SilkT/canfd-to-usb/hw/canfd-usb-nucleo-expb/canfd-usb-nucleo-expb.kicad_pcb

## KiCad design hw/canfd-usb-nucleo-expb/canfd-usb-nucleo-expb.kicad_pcb (2020-03-15)

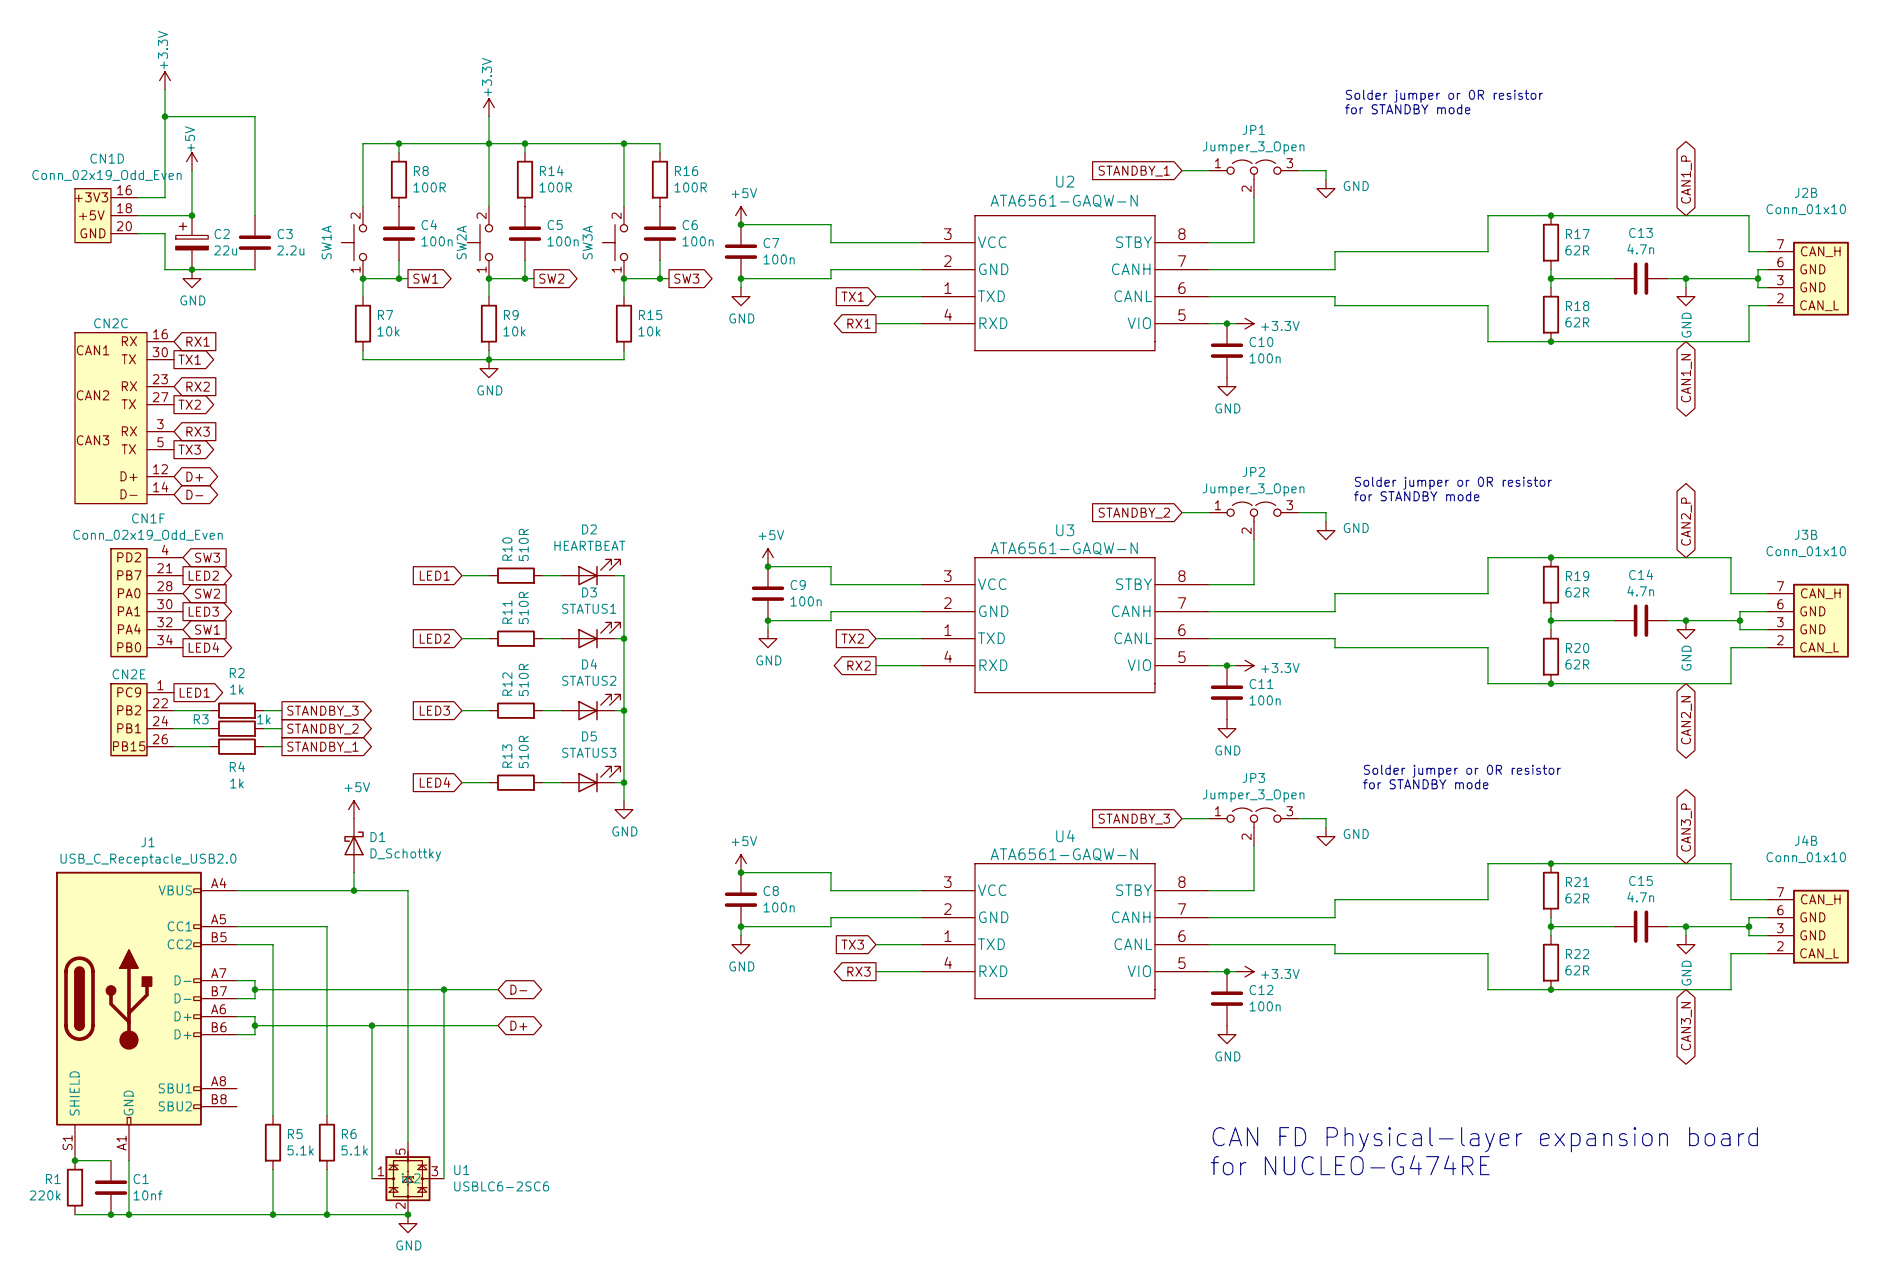
[picture p1: schematic canfd-usb-nucleo-expb.sch]

Parts:
C1: 10nf; C_0805_HandSoldering
C2: 22u; C_0805_HandSoldering
C3: 2.2u; C_0805_HandSoldering
C4, C5, C6, C7, C8, C9, C10, C11, C12: 100n; C_0805_HandSoldering
C13, C14, C15: 4.7n; C_0805_HandSoldering
CN1: Conn_02x19_Odd_Even; Pin_Header_Straight_2x19_Pitch2.54mm
CN2: CONN; Pin_Header_Straight_2x19_Pitch2.54mm
D1: D_Schottky; D_SOD-123
D2: HEARTBEAT; LED_D3.0mm
D3: STATUS1; LED_D3.0mm
D4: STATUS2; LED_D3.0mm
D5: STATUS3; LED_D3.0mm
J1: USB_C_Receptacle_USB2.0; L-KLS1-TIPEC-B
J2, J3, J4: Conn_01x10; IDC-Header_2x05_P2.54mm_Vertical
JP1, JP2, JP3: Jumper_3_Open; SolderJumper-3_P1.3mm_Open_RoundedPad1.0x1.5mm
R1: 220k; R_0805_HandSoldering
R2, R3, R4: 1k; R_0805_HandSoldering
R5, R6: 5.1k; R_0805_HandSoldering
R7, R9, R15: 10k; R_0805_HandSoldering
R8, R14, R16: 100R; R_0805_HandSoldering
R10, R11, R12, R13: 510R; R_0805_HandSoldering
R17, R18, R19, R20, R21, R22: 62R; R_0805_HandSoldering
SW1, SW2, SW3: SW_Push_Dual_x2; SW_PUSH_6mm
U1: USBLC6-2SC6; SOT-23-6_Handsoldering
U2, U3, U4: ATA6561-GAQW-N; SOIC-8_3.9x4.9mm_Pitch1.27mm

Connections:
+3V3: C3.1, C10.1, C11.1, C12.1, CN1.16, R8.1, R14.1, R16.1, SW1.2 (D), SW2.2 (D), SW3.2 (D), U2.5 (VIO), U3.5 (VIO), U4.5 (VIO)
+5V: C2.1, C7.1, C8.1, C9.1, CN1.18, D1.1 (K), U2.3 (VCC), U3.3 (VCC), U4.3 (VCC)
CAN1_N: J2.2, R18.2, U2.6 (CANL)
CAN1_P: J2.7, R17.1, U2.7 (CANH)
CAN2_N: J3.2, R20.2, U3.6 (CANL)
CAN2_P: J3.7, R19.1, U3.7 (CANH)
CAN3_N: J4.2, R22.2, U4.6 (CANL)
CAN3_P: J4.7, R21.1, U4.7 (CANH)
D+: CN2.12, J1.A6 (D+), J1.B6 (D+), U1.1, U1.6 (io1)
D-: CN2.14, J1.A7 (D-), J1.B7 (D-), U1.3 (io2), U1.4 (io2)
GND: C1.2, C2.2, C3.2, C7.2, C8.2, C9.2, C10.2, C11.2, C12.2, C13.2, C14.2, C15.2, CN1.20, D2.1 (K), D3.1 (K), D4.1 (K), D5.1 (K), J1.A1 (GND), J1.A12 (GND), J1.B1 (GND), J1.B12 (GND), J2.3, J2.6, J3.3, J3.6, J4.3, J4.6, JP1.3 (B), JP2.3 (B), JP3.3 (B), R1.1, R5.2, R6.2, R7.2, R9.2, R15.2, U1.2, U2.2 (GND), U3.2 (GND), U4.2 (GND)
LED1: CN2.1, R10.1
LED2: CN1.21, R11.1
LED3: CN1.30, R12.1
LED4: CN1.34, R13.1
unnamed: C1.1, J1.S1 (SHIELD), R1.2
unnamed: C4.1, R8.2
unnamed: C5.1, R14.2
unnamed: C6.1, R16.2
unnamed: C13.1, R17.2, R18.1
unnamed: C14.1, R19.2, R20.1
unnamed: C15.1, R21.2, R22.1
unnamed: CN2.22, R2.1
unnamed: CN2.24, R3.1
unnamed: CN2.26, R4.1
unnamed: D1.2 (A), J1.A4 (VBUS), J1.A9 (VBUS), J1.B4 (VBUS), J1.B9 (VBUS), U1.5
unnamed: D2.2 (A), R10.2
unnamed: D3.2 (A), R11.2
unnamed: D4.2 (A), R12.2
unnamed: D5.2 (A), R13.2
unnamed: J1.A5 (CC1), R6.1
unnamed: J1.B5 (CC2), R5.1
unnamed: JP1.2 (C), U2.8 (STBY)
unnamed: JP2.2 (C), U3.8 (STBY)
unnamed: JP3.2 (C), U4.8 (STBY)
RX1: CN2.16, U2.4 (RXD)
RX2: CN2.23, U3.4 (RXD)
RX3: CN2.3, U4.4 (RXD)
STANDBY_1: JP1.1 (A), R4.2
STANDBY_2: JP2.1 (A), R3.2
STANDBY_3: JP3.1 (A), R2.2
SW1: C4.2, CN1.32, R7.1, SW1.1 (C)
SW2: C5.2, CN1.28, R9.1, SW2.1 (C)
SW3: C6.2, CN1.4 (PD2), R15.1, SW3.1 (C)
TX1: CN2.30, U2.1 (TXD)
TX2: CN2.27, U3.1 (TXD)
TX3: CN2.5, U4.1 (TXD)

Notes on the sheet:
CAN FD Physical-layer expansion board for NUCLEO-G474RE
Solder jumper or 0R resistor for STANDBY mode

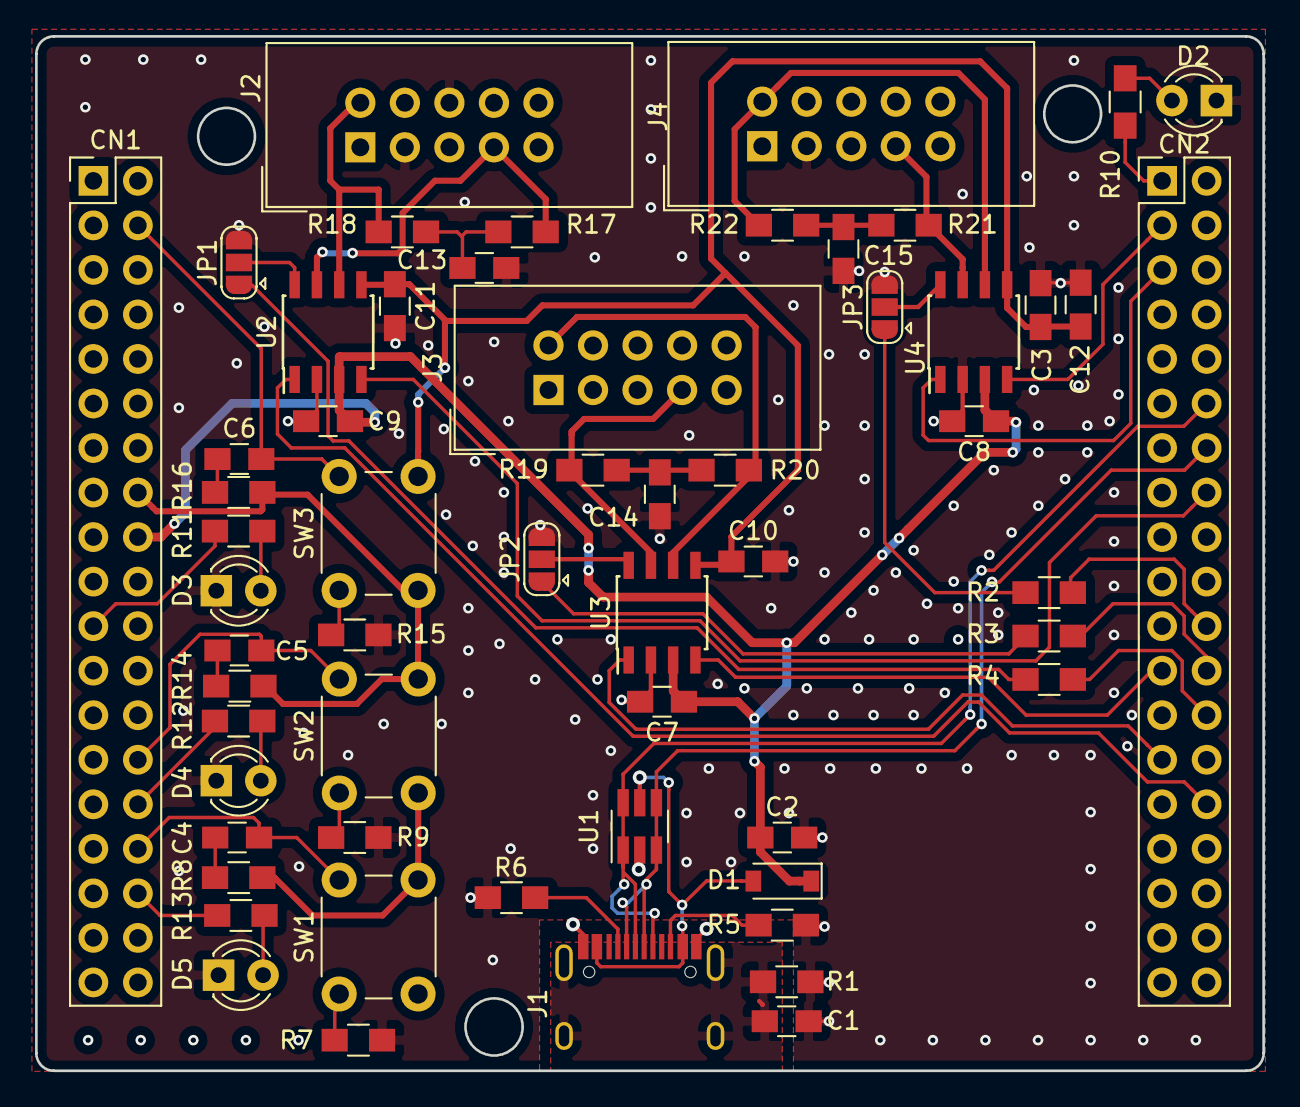
[picture p2: board canfd-usb-nucleo-expb.kicad_pcb from above]

Board: 2 copper layers, 70.0 x 59.0 mm, 58 parts (0 on the bottom side), 47 nets.
